pimentpoulet/PFE/Images/plan du site.jpg

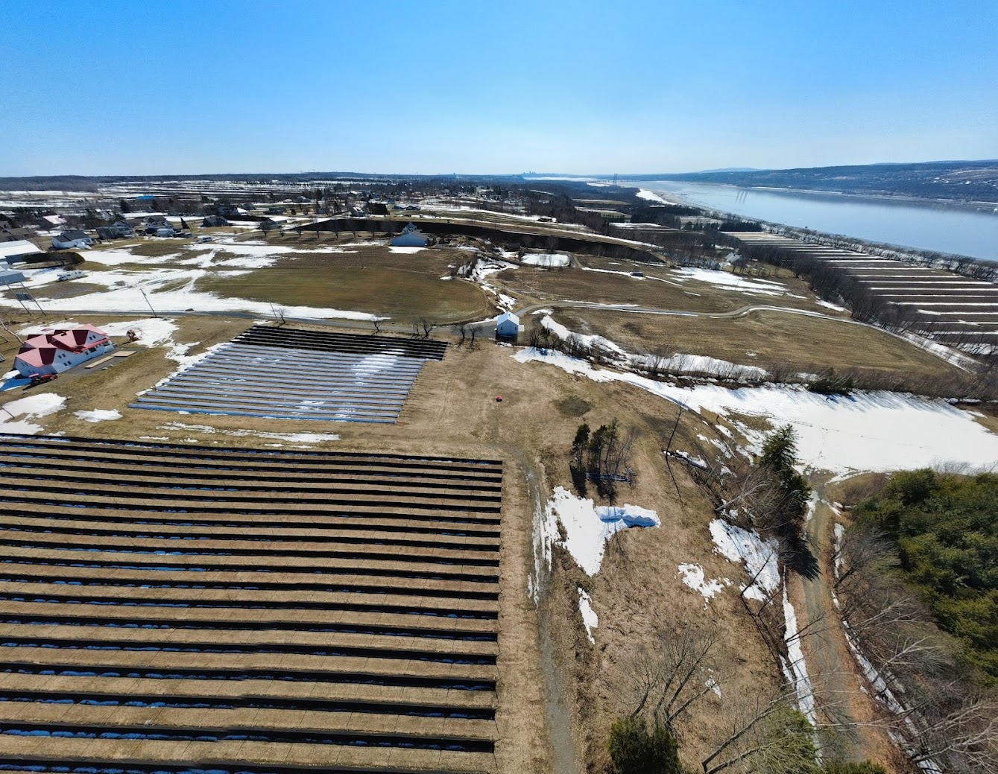
Images/plan du site.jpg
