pimentpoulet/PFE/Images/casing_2.jpg

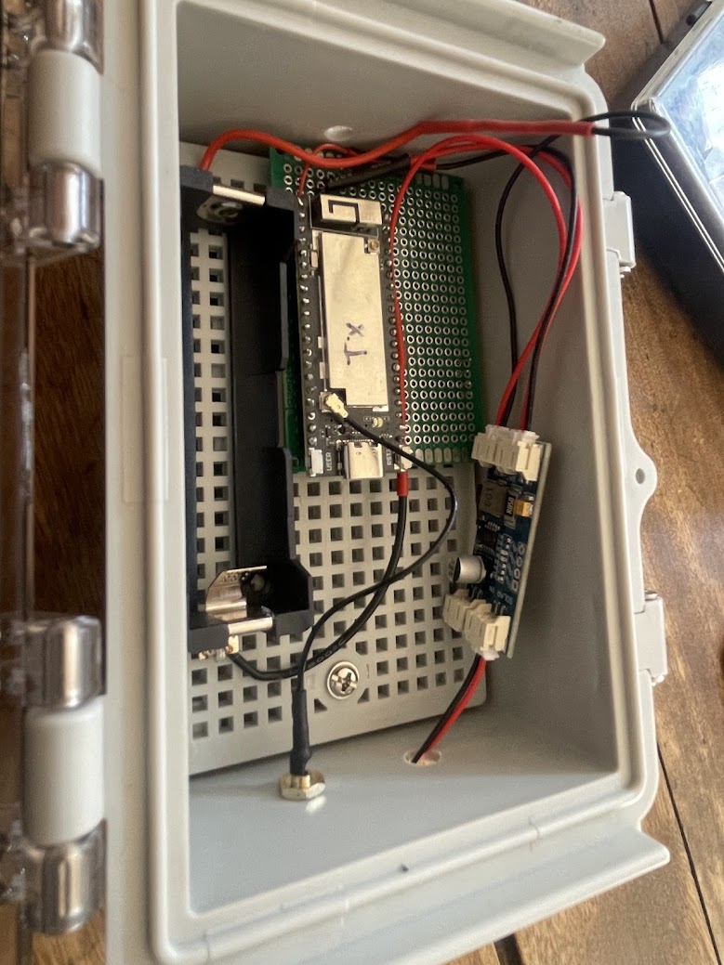
Images/casing_2.jpg
