pimentpoulet/PFE/Ruche connectée.pptx

## Ruche connectée

Clément P.
Michel P. (sup.)

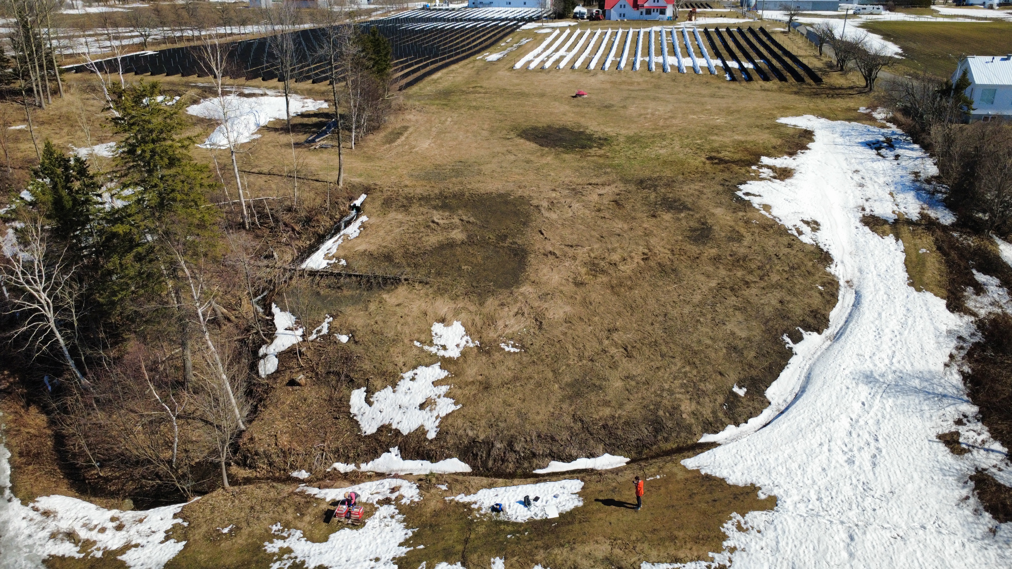
[picture p3: figure]

## Problématique

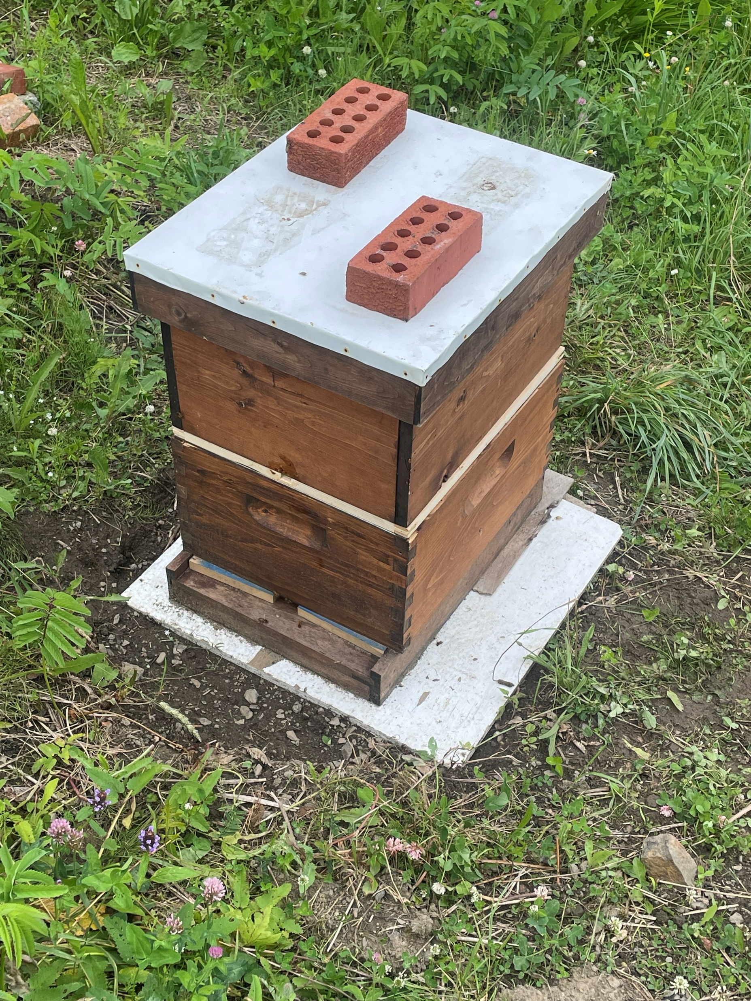
[picture p4: figure]
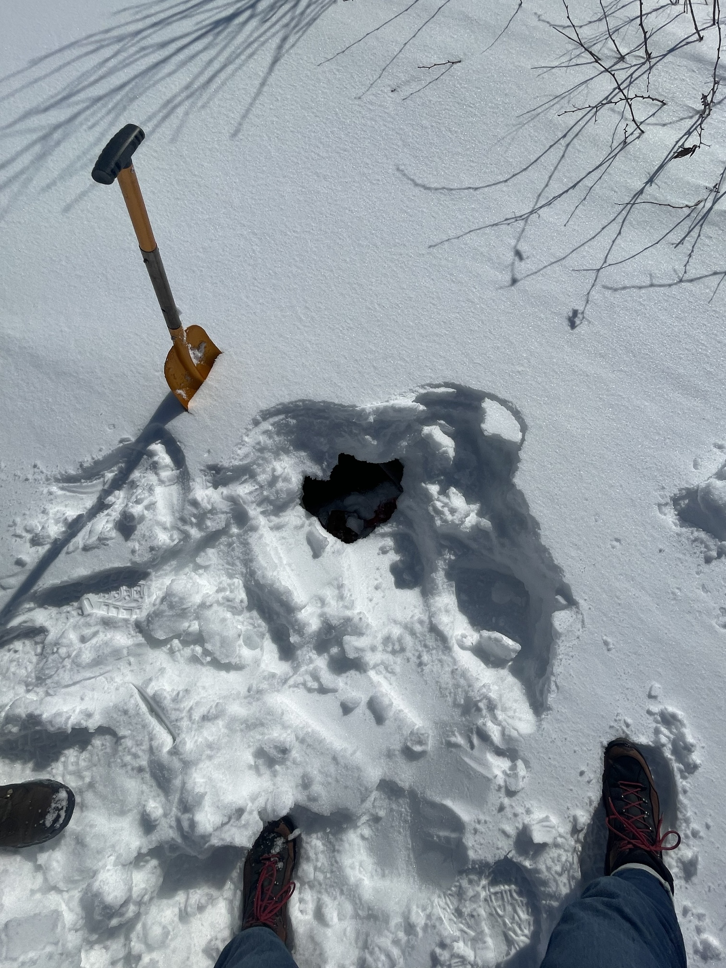
[picture p5: figure]

- État de santé inconnu
- Besoin de déplacement
- Suivi dans le temps compliqué
- Il n’y a pas de réseau à proximité

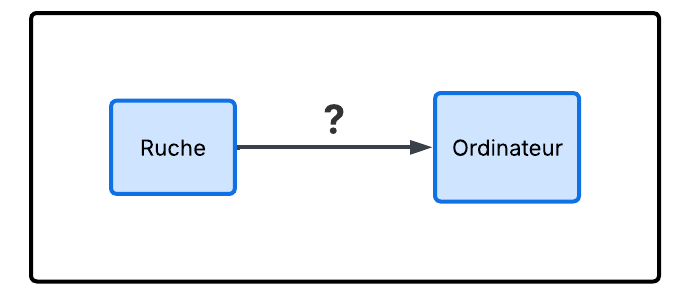
[picture p6: figure]

## Slide 3

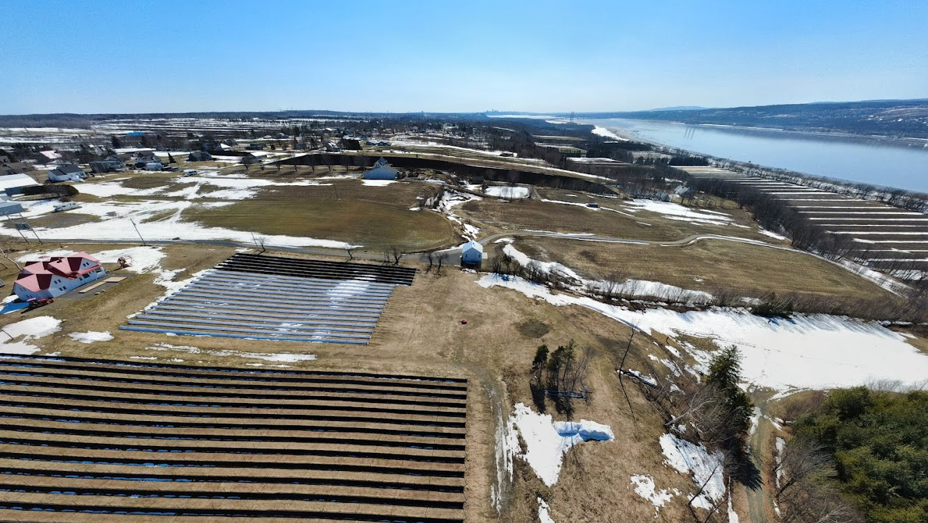
[picture p7: figure]

Plan du site

Centre-ville (maison)

Wi-Fi le plus proche

Distance: ~18km

Distance: ~200m

Ruches

## Solution proposée: Traitement / LoRa

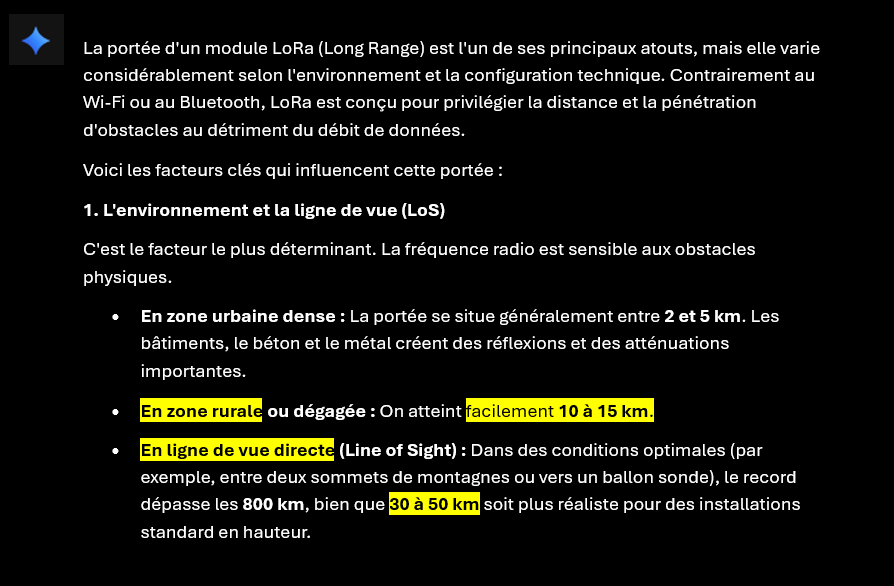
[picture p8: figure]
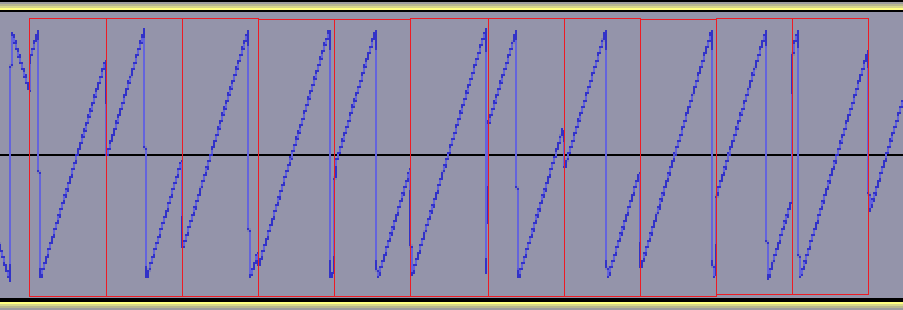
[picture p9: figure]
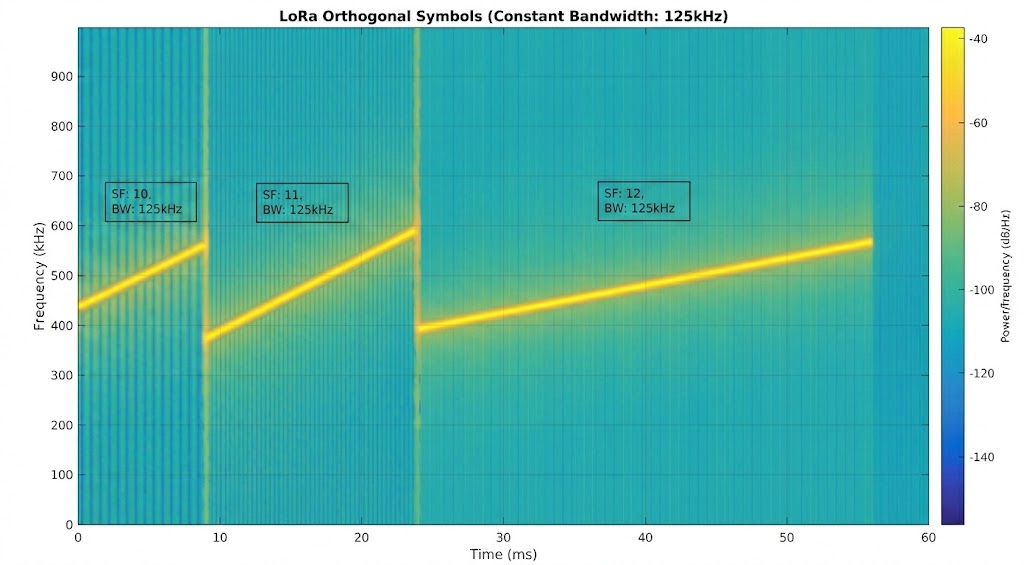
[picture p10: figure]

## Solution proposée: Traitement / LoRa

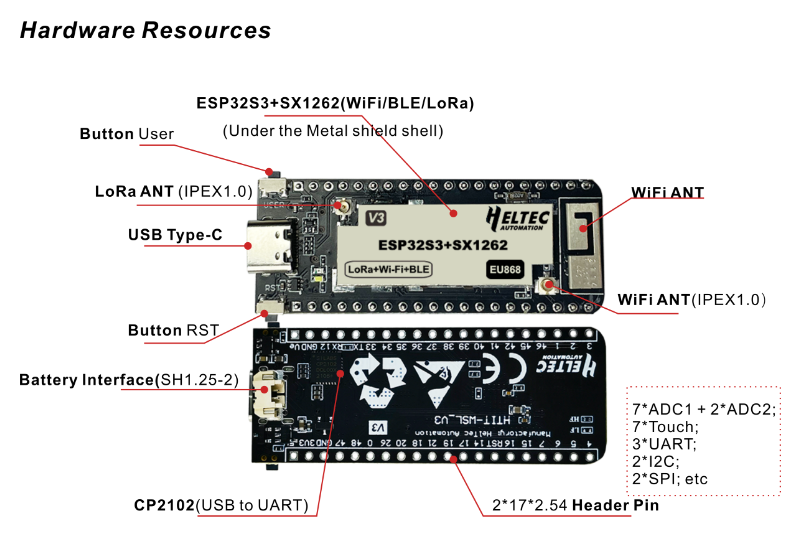
[picture p11: figure]

## Solution proposée : Données

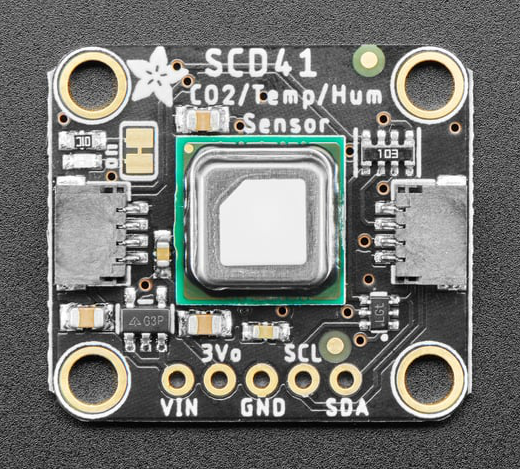
[picture p12: figure]
Top view of Adafruit SCD-41 - NDIR CO2 Temperature and Humidity Sensor.
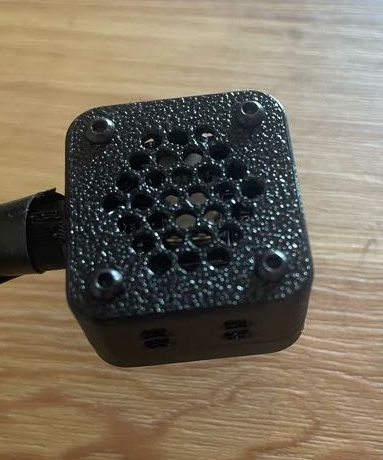
[picture p13: figure]
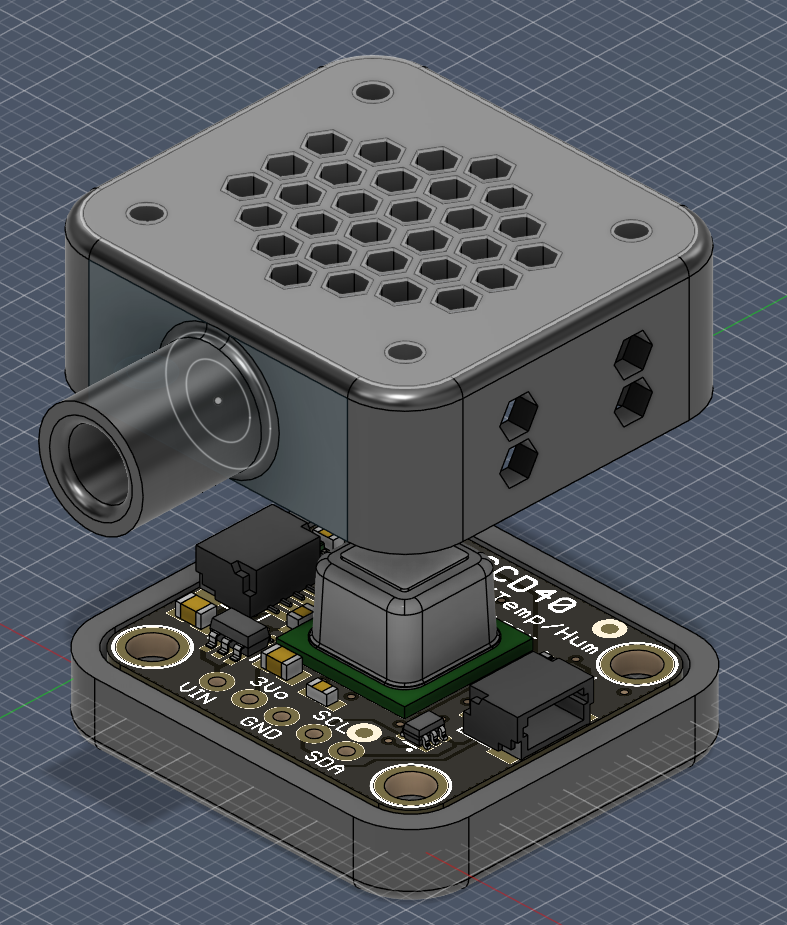
[picture p14: figure]
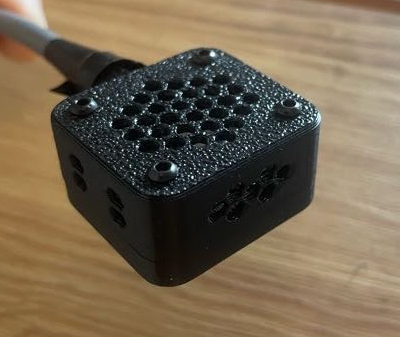
[picture p15: figure]

Notes: CO2: 400-5000ppm \pm 40ppm
Temp: -10 – 60C -> \pm 0.8C
Hum: 0-100% -> \pm 6%

## Solution proposée: Alimentation

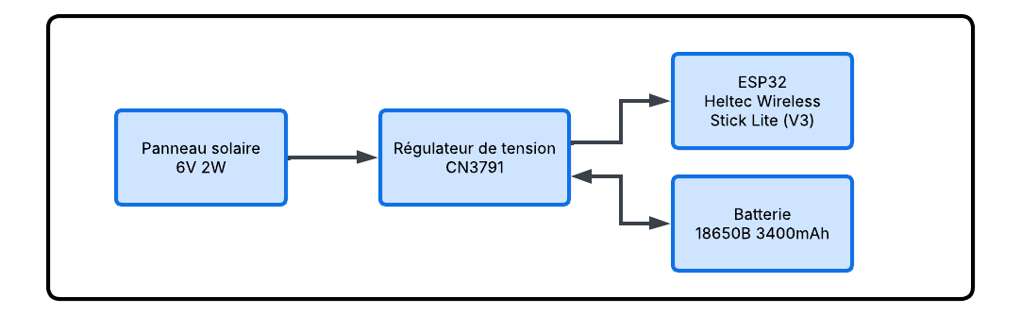
[picture p16: figure]
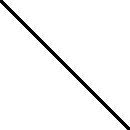
[picture p17: figure]
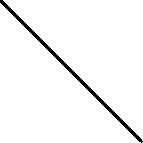
[picture p18: figure]
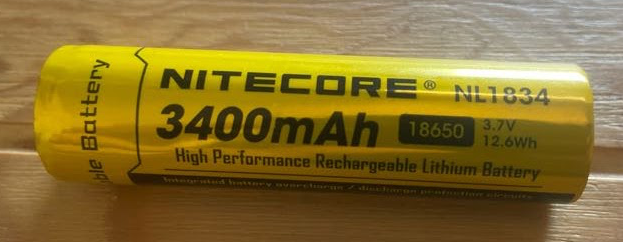
[picture p19: figure]
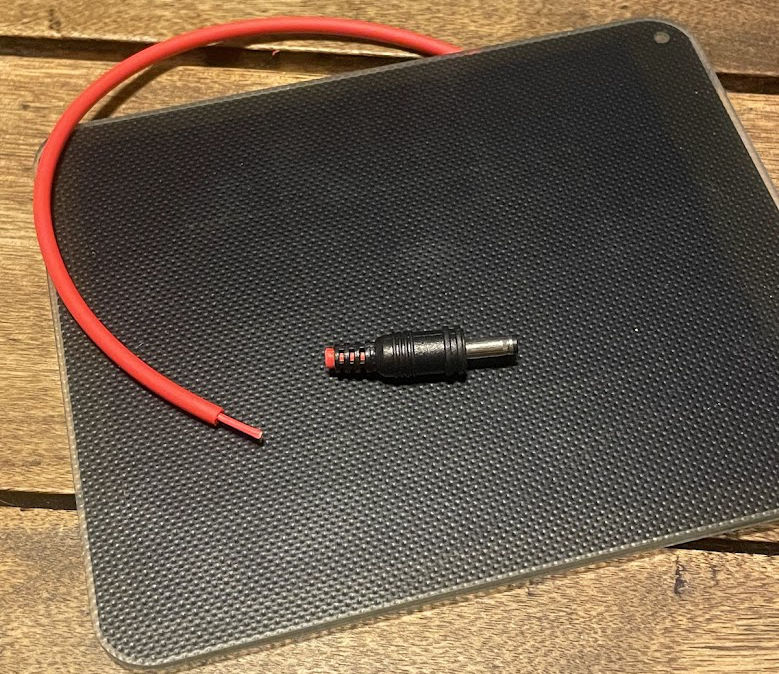
[picture p20: figure]
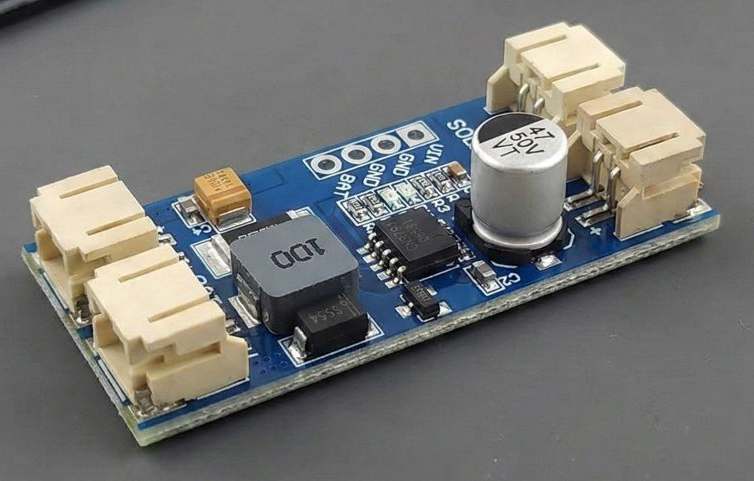
[picture p21: figure]
CN3791 MPPT Solar Li-ion/LiPo Charging Boards: what they are and how to use them safely

Notes: 0.193mAh par cycle
4.64mAh par jour
Batterie 3400 mAh --> ~700 jours

Puissance / jour : 17.2mWh ~ sécurité --> *1.7 = 29.2 mWh --> 2W est largement suffisant

## Solution proposée: Intégration

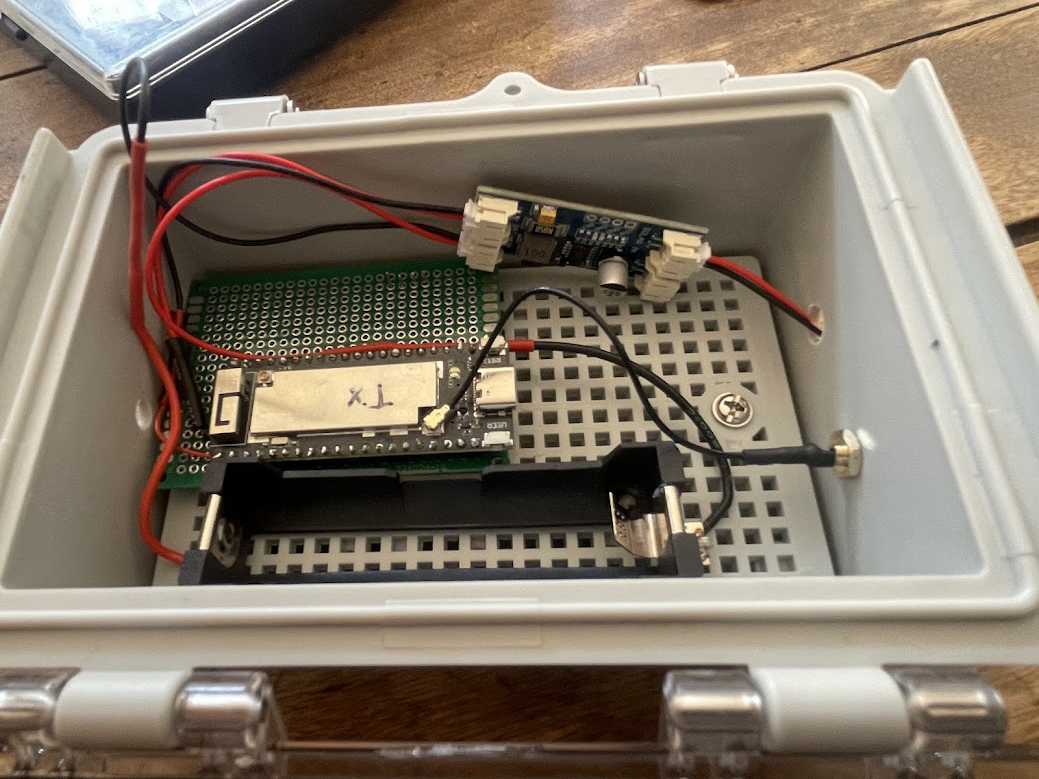
[picture p22: figure]
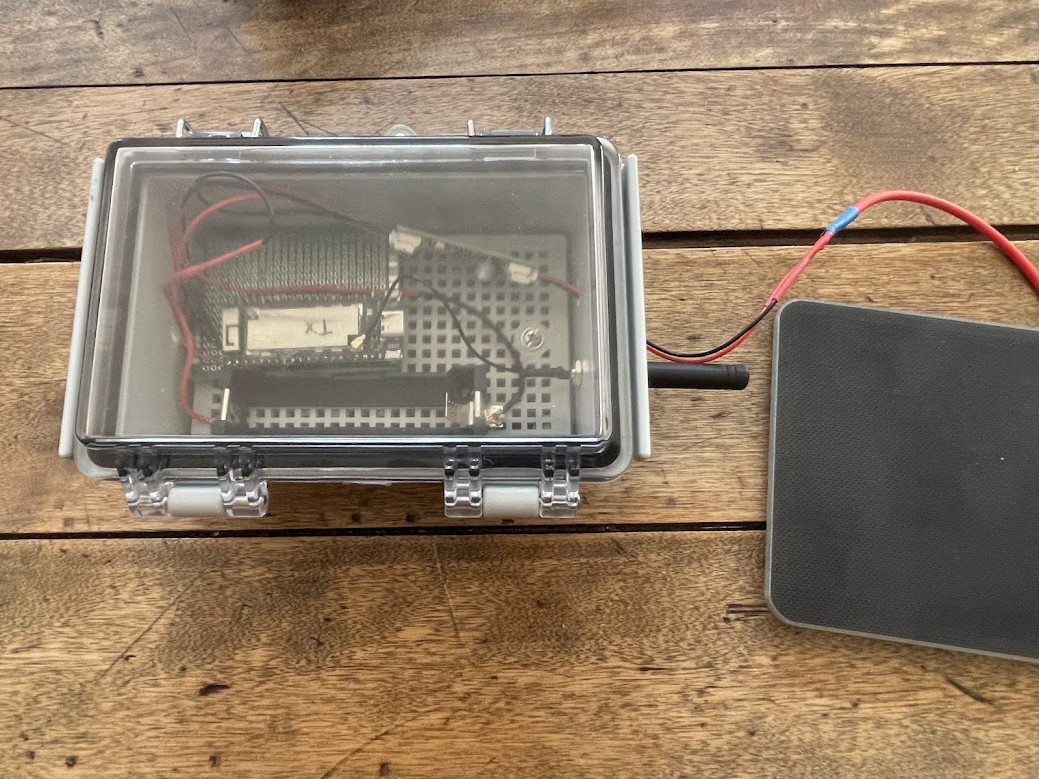
[picture p23: figure]

## Solution proposée : Serveur

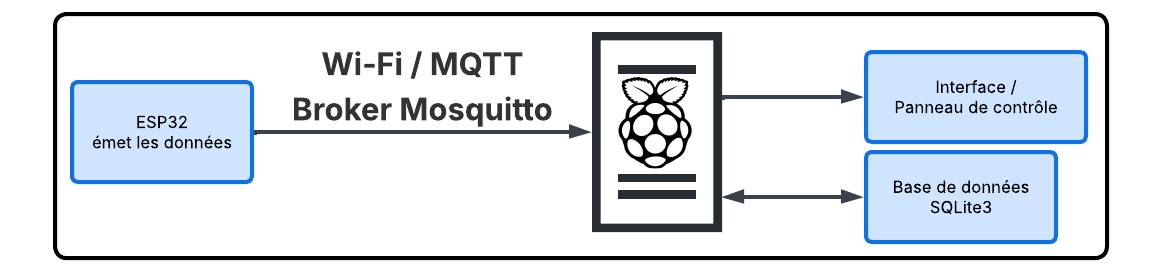
[picture p24: figure]
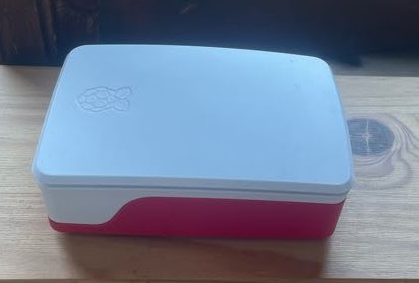
[picture p25: figure]
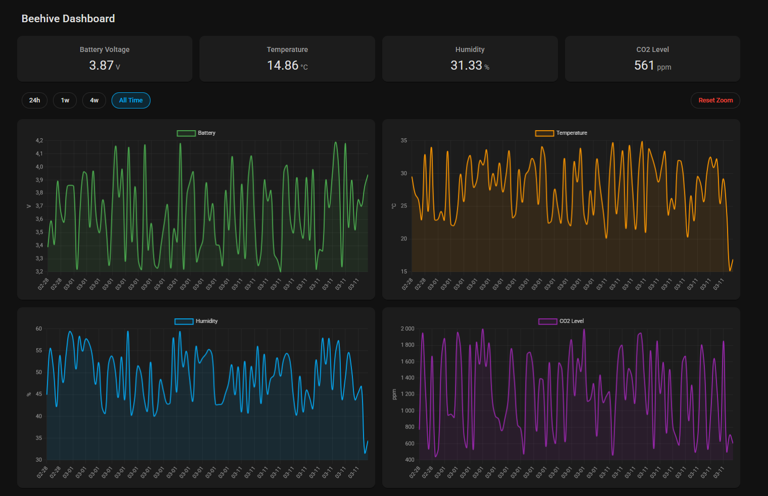
[picture p26: figure]

## Solution proposée : Serveur

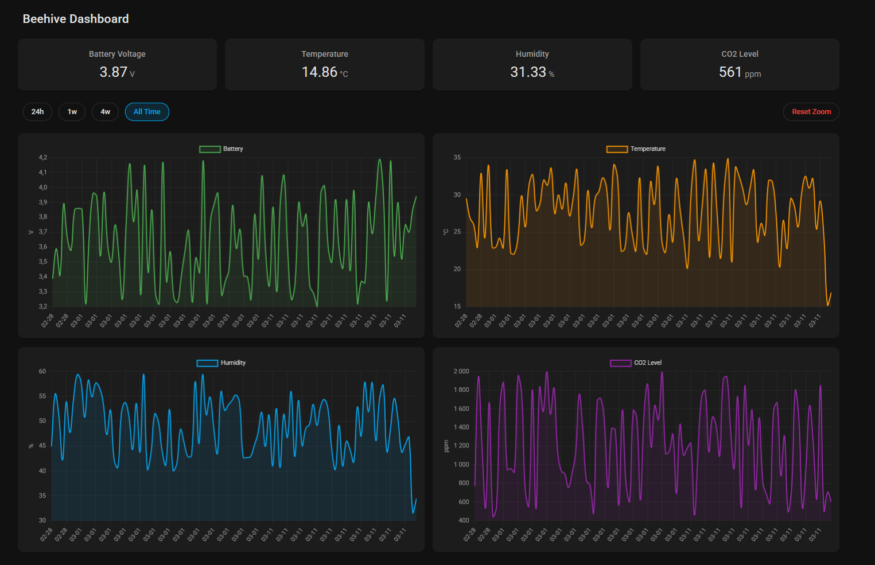
[picture p27: figure]

*Données de tests*

## Solution proposée: Schéma global

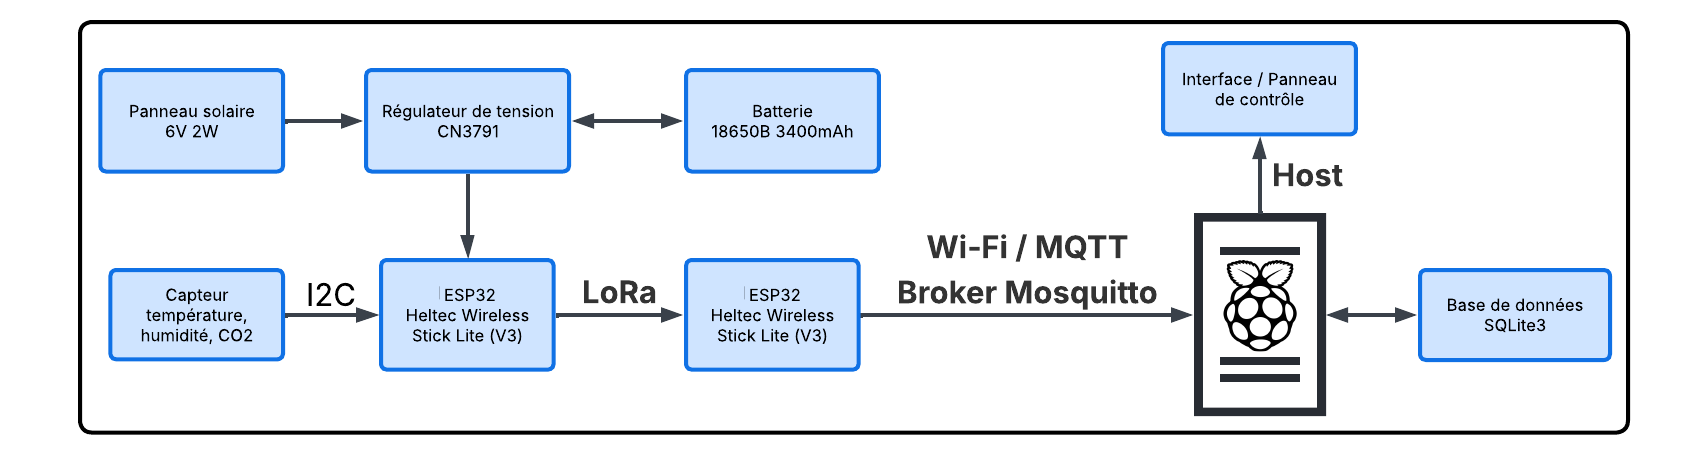
[picture p28: figure]

## Tests de portée – maison

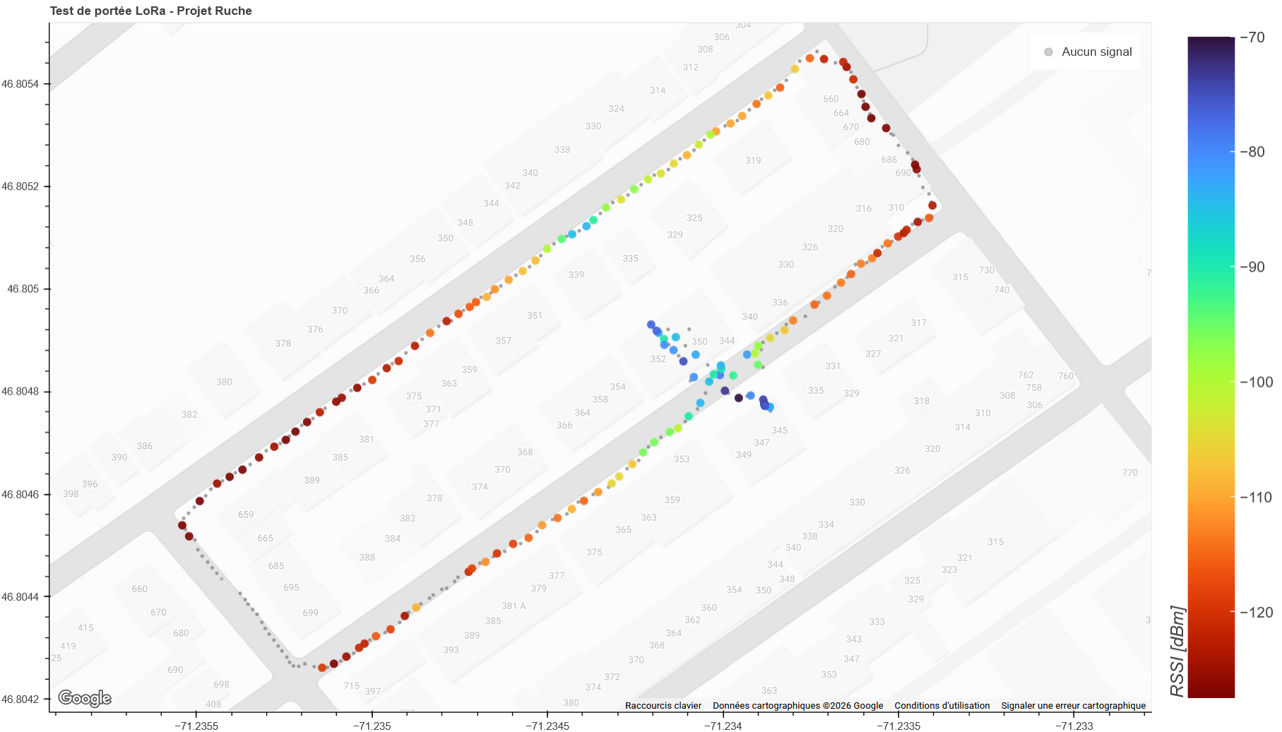
[picture p29: figure]

## Tests de portée – sur site

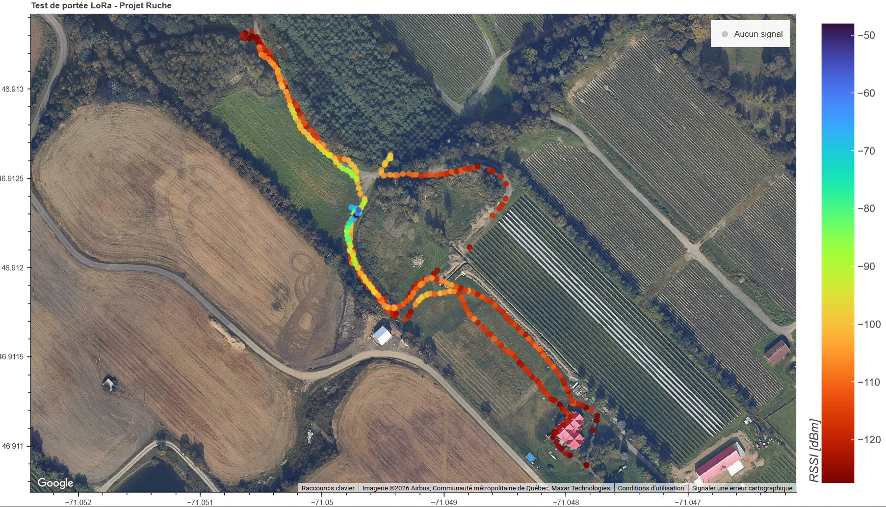
[picture p30: figure]

## Choses à faire

- Tests de portée avec différents paramètres LoRa
- Tests de portée avec réflecteurs à λ/2
- Mise en place définitive du boîtier
- Insertion dans la ruche
- Validation du lien de communication via MQTT Broker
- Changement de l’interface pour le mettre en français⚜️

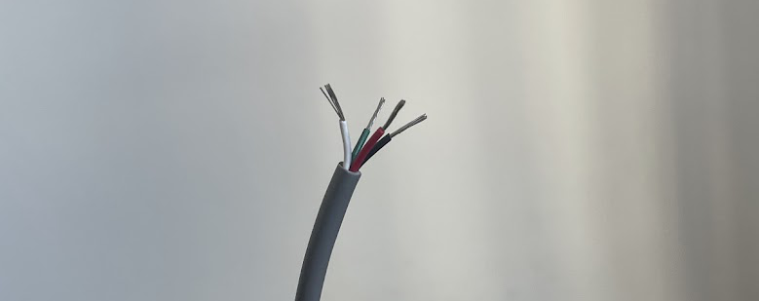
[picture p31: figure]

## Budget

Composante | Quantité | Prix
MCU esp32 | 2 | 22.58$CAD
Capteur SCD41 | 1 | 30.79$CAD
Panneau solaire 6V 2W | 1 | 20.95$CAD
Batterie NRC18650B | 1 | 52.43$CAD
Régulateur de tension CN3791 | 1 | 13.29$CAD
Raspberry Pi 5 | 1 | 151.74$CAD
Carte SD | 1 | 37.95$CAD
Câbles et autres* | - | 41.59$CAD
Total (avec taxes)** | | 393.8$CAD

* inclut le boîtier, le boîtier pour la batterie et tous les connecteurs / adaptateurs
** sans compter les doublons

## Échéancier

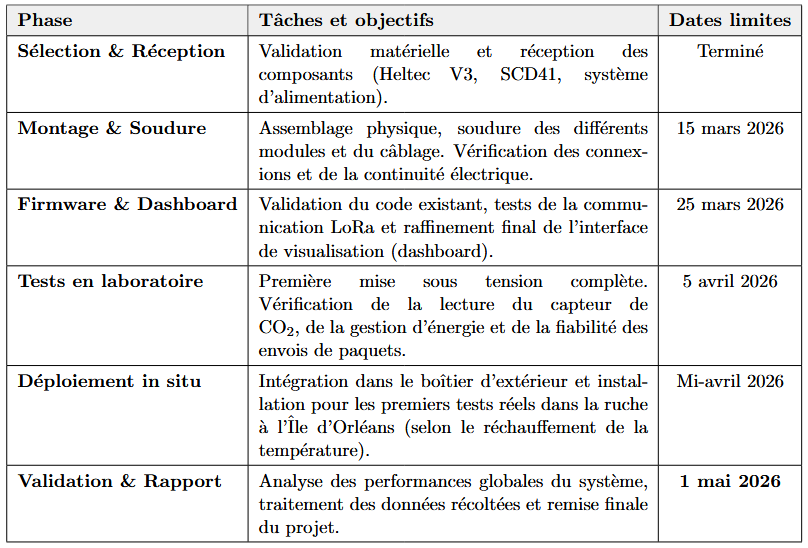
[picture p32: figure]
