pimentpoulet/PFE/PFE_1.pdf

Département de physique, de génie physique et d’optique

Projet de fin d’études
GPH-3001
Hiver 2026

Détail du projet et plan de travail

Clément Poulin (536 994 304)

Date : 30 janvier 2026

## 1 Introduction

L’apiculture moderne fait face à des défis croissants liés aux changements climatiques et à la santé des colonies. L’un des gros défis pour l’apiculture québécoise est la préparation des colonies à l’hivernage, un processus critique où les abeilles doivent avoir suffisamment de réserve de nourriture pour passer l’hiver. Au Québec, le vent et la température hivernale sont de gros facteurs ayant un impact sur l’hivernage des ruches. Un autre facteur préoccupant à chaque année est la quantité de neige qui tombe en hiver. Comme une bonne partie de l’isolation des ruches est due à l’épaisseur de la neige au sol, il faut à chaque automne nourrir les colonies pour qu’elles passent l’hiver et ce peu importe les précipitations de neige. Ce projet, réalisé à l’Île d’Orléans, vise à instrumenter une ruche existante pour permettre un suivi à distance précis. En combinant de l’électronique et, possiblement, les principes de la photonique, il cherche à proposer une solution robuste pour surveiller l’état interne des colonies sans intervention physique disruptive lorsque les apiculteurs ne sont pas directement sur le site.

## 2 Problématique

Un bon apiculteur est un scientifique qui réussi à interpréter les signes que donnent les colonies et à agir en conséquence pour assurer la pérennité de ses abeilles. De façon générale, c’est son habileté à détecter ces signaux qui le distingue d’un débutant et qui facilite son travail au fil des saisons. Pour les apiculteurs qui débutent, il est donc difficile d’interpréter les colonies et poser les bons gestes. Ce projet vise donc à augmenter la visibilité de l’état de santé des colonies par des moyens technologiques. Ces moyens technologiques impliquent plusieurs défis, allant de la gestion des données à la communication et à la visualisation des données.

## 3 Description du projet et objectifs

Le projet consiste à concevoir un système de télémétrie multisensoriel dont les objectifs principaux sont :

- Surveillance environnementale : Mesurer en temps réel la température, l’humidité et le taux de CO2 de la ruche grâce à des capteurs.
- Analyse biologique : Mesurer le niveau de décibels acoustiques pour évaluer l’activité de la colonie.
- Connectivité distante : Etablir un lien de communication fiable entre l’ ´ | Île d’Orléans et
Québec.
- Visualisation : Centraliser les données sur un tableau de bord ergonomique et tenir une base de données ou un fichier permettant de stocker l’information sur une longue durée.
- Autonomie : Assurer une autonomie énergétique du système tout au long de l’année.

Projet de fin d’études
Détail du projet et plan de travail

GPH-3001
Hiver 2026

1

### 3.1 Défis de la surveillance multisensorielle :

Le maintien d’un environnement stable est vital pour la survie des abeilles, particulièrement durant l’hiver. Le défi principal réside dans la sélection et l’intégration de capteurs capables de fonctionner dans un milieu saturé d’humidité et d’encombrement biologique, la propolis :

- Environnemental : La précision des capteurs de température, d’humidité et de CO2 est critique pour détecter précocement une anomalie thermique ou une ventilation inadéquate. Une température trop élevée en été peut montrer un manque de ventilation et est un risque pour les abeilles, qui ont tendance à se laisser mourir lorsque la température monte trop[1]. À l’inverse, une température trop faible en hiver peut indiquer que la colonie est morte. Quant au CO2, les abeilles faisant de la respiration cellulaire, un taux élevé peut indiquer une forte densité de population ou un manque de ventilation.
- Acoustique et vision : L’ajout d’un microphone vise à interpréter le niveau d’activité de la colonie. L’analyse du signal sonore permet de détecter des comportements coloniaux com-plexes. Selon les travaux de Ferrari et al. [2], une augmentation de l’énergie acoustique dans la plage des 100 Hz à 300 Hz est un indicateur précurseur fiable de l’essaimage¹
, permettant
une intervention apicole préventive.

### 3.2 Robustesse face aux interventions apicoles

L’ajout de capteurs ne doit pas empêcher les opérations courantes. Les inspections hebdomadaires au rucher impliquent des manipulations où les hausses des ruches sont déplacées et légèrement brassées. Le prototype doit présenter une architecture robuste et des fixations de capteurs résilientes pour supporter ces déplacements fréquents tout en maintenant l’étalonnage et la connectivité des dispositifs.

### 3.3 Autonomie énergétique et transfert de données

Bien que le site soit accessible, l’alimentation électrique demeure un enjeu majeur. Le système doit minimiser sa consommation pour permettre une autonomie via batterie (éventuellement couplée à une éolienne) ou supporter les contraintes d’un raccordement au réseau de la ferme située à 150 mètres. Cette distance pourrait imposer une transition technologique à un certain point durant le projet : débuter par une liaison câblée pour la validation, puis migrer vers une communication par fibre optique afin de garantir l’intégrité de la connexion face aux distances de transmission. Une fibre optique est aussi beaucoup moins sensible aux variations de température.

1L’essaimage est l’envol d’une partie de la colonie lorsque la population devient trop élevée. C’est une opération qui laisse la colonie sans reine féconde, ce qui réduit les chances de survie naturelle de la colonie.

Projet de fin d’études
Détail du projet et plan de travail

GPH-3001
Hiver 2026

2

## 4 Barèmes du cahier des charges

Le cahier des charges est résumé dans le tableau 1.

### 4.1 Plage d’opération des capteurs

Température : Le système reçoit le pointage maximal s’il maintient une acquisition stable entre -40°C et 55°C, couvrant les extrêmes climatiques de l’Île d’Orléans. L’incertitude sur la limite inférieure ne doit pas excéder 2°C. Un score de 3 pts est accordé si la plage est limitée à [-20°C, 45°C]. 0 pt est attribué si le capteur sature avant d’atteindre les seuils critiques de survie de la grappe hivernale.

Humidité : Ce barème évalue la capacité à mesurer l’humidité relative (%HR) de 0% à 100%. En raison de l’environnement saturé de la ruche, 7 pts sont accordés si le capteur peut récupérer ses spécifications après une condensation totale. Si le capteur dérive ou sature de façon permanente au-dessus de 90% HR, le score est réduit à 2 pts.

Taux de CO2 : Le maximum de points est accordé pour une plage de mesure allant jusqu’à 10 000 ppm. Comme le métabolisme des abeilles produit des concentrations élevées, un capteur limité à 2 000 ppm reçoit 0 pt, car il serait incapable de quantifier les pics d’activité respiratoire de la colonie.

Plage fréquentielle : Le système doit présenter une réponse en fréquence plate entre 20 Hz et 2000 Hz pour capter le spectre complet des vibrations coloniales. Une atténuation majeure (¿ 6 dB) dans la bande de l’essaimage (100-300 Hz) réduit le score à 1 pt.

### 4.2 Précision des capteurs

Température : 7 pts sont accordés pour une incertitude de mesure inférieure ou égale à +/-0.1°C, permettant un suivi fin de l’homéostasie du couvain. Une précision de +/- 1°C récolte 3 pts. Au-delà d’une incertitude de +/- 2°C, la donnée est jugée insuffisante pour une analyse biologique fiable et reçoit 0 pt.

Humidité : Le pointage maximal requiert une précision de +/- 2% HR. Entre 2% et 5%, le score est de 4 pts. Une incertitude supérieure à 10% HR ou une absence de compensation thermique de la mesure d’humidité entraîne un score de 0 pt.

Taux de CO2 : 3 pts sont attribués si l’erreur de mesure est inférieure à 3% de la valeur réelle. Etant donné l’importance de ce gaz pour la régulation de la ventilation, une erreur supérieure à ´ 10% ou une dérive temporelle non calibrée (drift) annule les points de ce critère.

Plage fréquentielle : Ce critère évalue la résolution spectrale de la transformée de Fourier (FFT).

Projet de fin d’études
Détail du projet et plan de travail

GPH-3001
Hiver 2026

3

Le maximum est accordé pour une résolution inférieure ou égale à 5 Hz par bin, essentielle pour isoler les signatures acoustiques. Une résolution trop grossière (¿ 20 Hz) ne permet pas de distinguer les signaux d’intérêt et reçoit 0 pt.

### 4.3 Fiabilité de la communication et tableau de bord

Fiabilité de la connexion : Evalue la stabilité du lien de communication de 150m vers Québec. ´ 25 pts sont accordés pour une disponibilité du signal supérieure à 99% (uptime). Le score est réduit proportionnellement au taux de perte de paquets ou de déconnexions lors d’intempéries (ex: 10 pts pour 80% de stabilité).

Lisibilité et convivialité : Barème qualitatif basé sur l’ergonomie du tableau de bord. 10 pts si un utilisateur peut identifier une anomalie thermique, acoustique ou autres en moins de 5 secondes. 0 pt si l’interface est surchargée, instable ou nécessite une conversion manuelle des données brutes par l’apiculteur.

Actualisation des données : 5 pts si le délai entre la capture et l’affichage à Québec est inférieur à 1 minute. Le score est de 0 pt si l’actualisation excède 10 minutes, rendant le monitoring inefficace pour une intervention d’urgence.

### 4.4 Autonomie et robutesse

Autonomie énergétique : Le système reçoit 15 pts s’il peut fonctionner de manière totalement autonome pendant 48h sans apport externe (solaire ou éolien). Le score diminue de 5 pts par tranche de 12h d’autonomie manquante par rapport à cette cible.

Robustesse globale :

Manipulations : Evalué par un test de résistance aux vibrations. Le prototype doit rester fonc- ´ tionnel et conserver l’intégrité de ses branchements après que les hausses de la ruche aient été manipulées ou déplacées brusquement.

Conditions environnementales : 2.5 pts si aucune défaillance n’est observée après une exposition à l’humidité interne et aux agents corrosifs (propolis/cire). 0 pt si des débris bloquent les ouvertures acoustiques ou les membranes des capteurs.

Projet de fin d’études
Détail du projet et plan de travail

GPH-3001
Hiver 2026

4

## 5 Cahier des charges

Paramètres | Pond. | Barême | Min | Max
Plage d’opération des capteurs ◦C] Température [ [%HR] Humidité Taux de CO2 [ppm] Plage frqéuentielle [Hz] | 20 7 7 3 3 | 4.1 4.1 4.1 4.1 | -40 0 0 20 | 55 100 10000 2000
Précision des capteurs ◦C] Température [ Humidité [%HR] Taux de CO2 [ppm] [Hz] Plage fréquentielle | 20 7 7 3 3 | 4.2 4.2 4.2 4.2 | ±1 5% 3% - | ±0.1 2% --
Fiabilité de la connexion longue distance | 25 | 4.3 | - | -
Tableau de bord Lisibilité des données et facilité d’utilisation Actualisation des données régulièrement | 15 10 5 | 4.3 4.3 | -- | --
Autonomie énergétique | 15 | 4.4 | - | -
Robustesse globale du système face aux manipulations des opérateurs face aux conditions environnementales | 5 2.5 2.5 | 4.4 4.4 | -- | --

Tableau 1

Projet de fin d’études
Détail du projet et plan de travail

GPH-3001
Hiver 2026

5

## 6 Echéancier ´

Phase | Tâches et objectifs | Dates limites
Design & Sélection | Recensement final des capteurs et composants. Etude de faisabilité ESP32. Choix entre ´ intégration directe ou modules. | 8 fév. 2026
Conception PCB | Saisie du schéma électronique et routage du circuit (Layout). Commande des PCBs auprès du fabri-cant. | 1 mars 2026
Firmware (Base) | Programmation de la lecture des capteurs sur plaque d’essai. Test des protocoles (Wi-Fi/Fibre). | 15 mars 2026
Montage & Soudure | Réception des PCBs, soudure des composants et tests de continuité électrique. | 25 mars 2026
Dashboard & Cloud | Développement de l’interface de visualisation (Grafana/Web) et base de données distante. | 10 avril 2026
Intégration Physique | Fabrication du boîtier robuste (IP65) et installa-tion finale au vignoble (Île d’Orléans). | 20 avril 2026
Validation & Rapport | Analyse des données, calcul des incertitudes et remise finale du projet GPH-3001. | 1 mai 2026

Tableau 2: Echéancier de réalisation. ´

## References

[1] Radio-Canada, | “Le | stress | thermique | cause | l’éjaculation | mortelle
des | faux-bourdons.” | https://ici.radio-canada.ca/nouvelle/1866437/
abeilles-ruches-changements-climatiques-cb-ubc-recherche-ejaculation, (https://ici.radio-canada.ca/nouvelle/1866437/abeilles-ruches-changements-climatiques-cb-ubc-recherche-ejaculation) | 2022.
Consulté le 30 janvier 2026.
[2] S. Ferrari, M. Silva, M. Guarino, and D. Berckmans, “Monitoring of swarming sounds in bee colonies for early detection,” Computers and Electronics in Agriculture, vol. 64, no. 1, pp. 72–77, 2008.

Projet de fin d’études
Détail du projet et plan de travail

GPH-3001
Hiver 2026

6
