pimentpoulet/PFE/Images/Alimentation.jpg

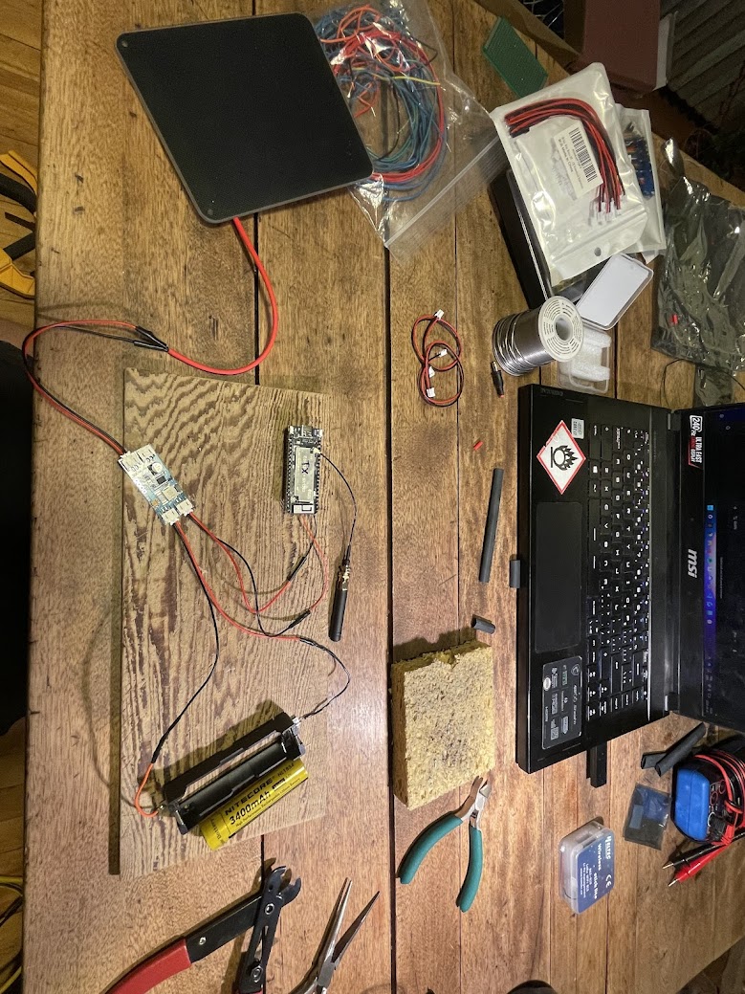
Images/Alimentation.jpg
