pimentpoulet/PFE/Images/casing_1.jpg

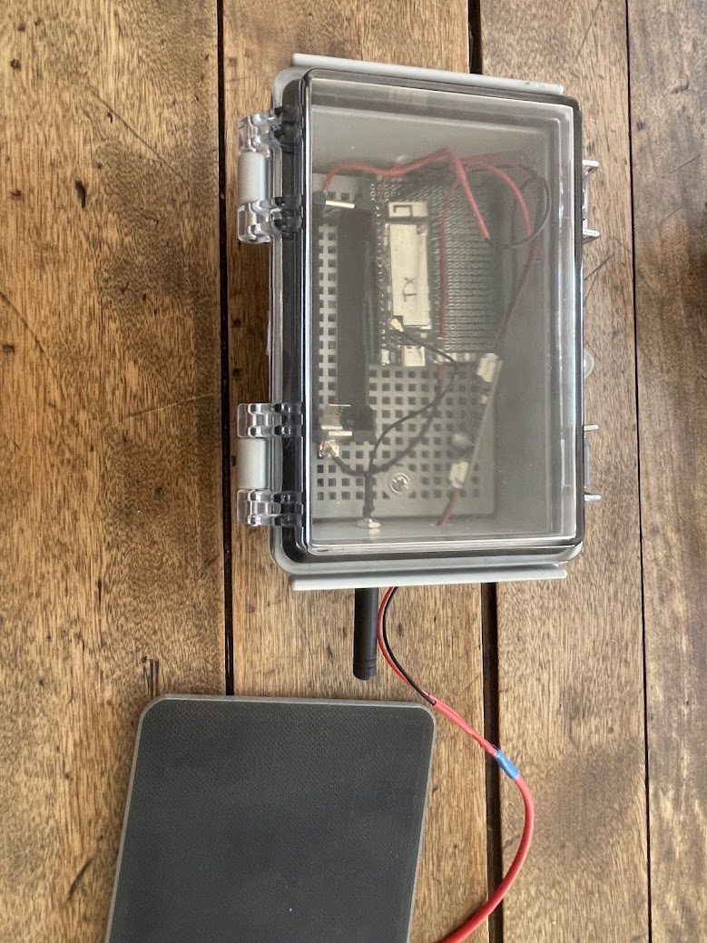
Images/casing_1.jpg
