pimentpoulet/PFE/Images/Dashboard.png

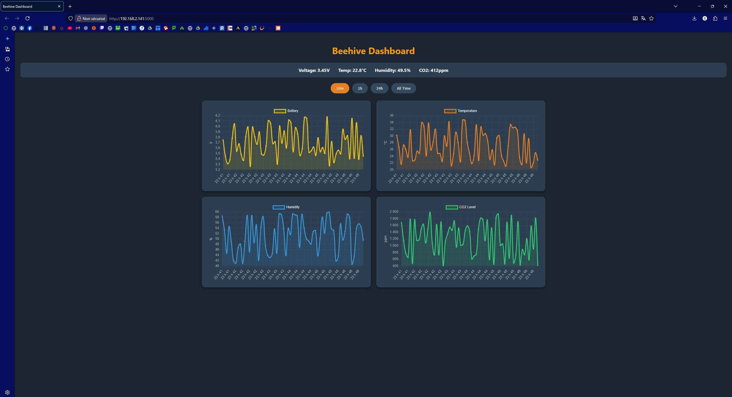
Images/Dashboard.png
