pimentpoulet/PFE/Images/Dashboard_2.png

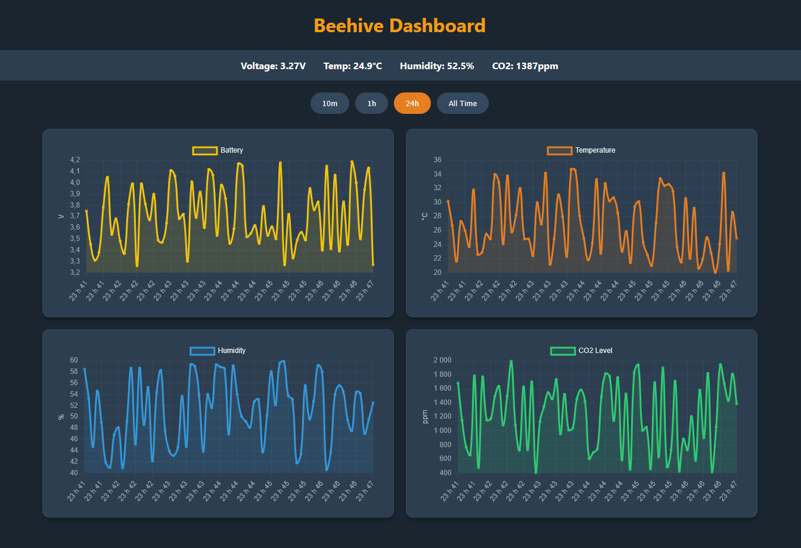
Images/Dashboard_2.png
