pimentpoulet/PFE/Images/Fils_capteurs.jpg

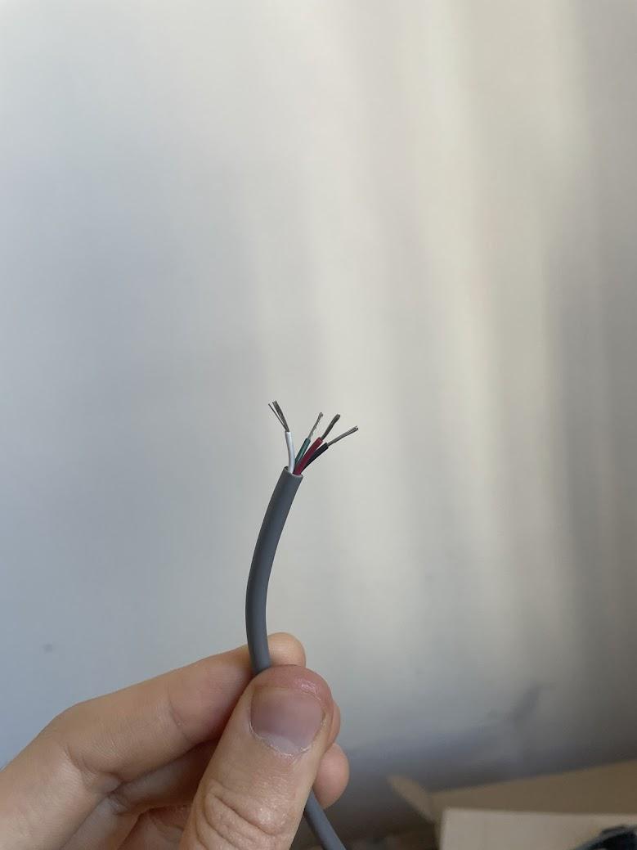
Images/Fils_capteurs.jpg
