pimentpoulet/PFE/Images/RPI5.jpg

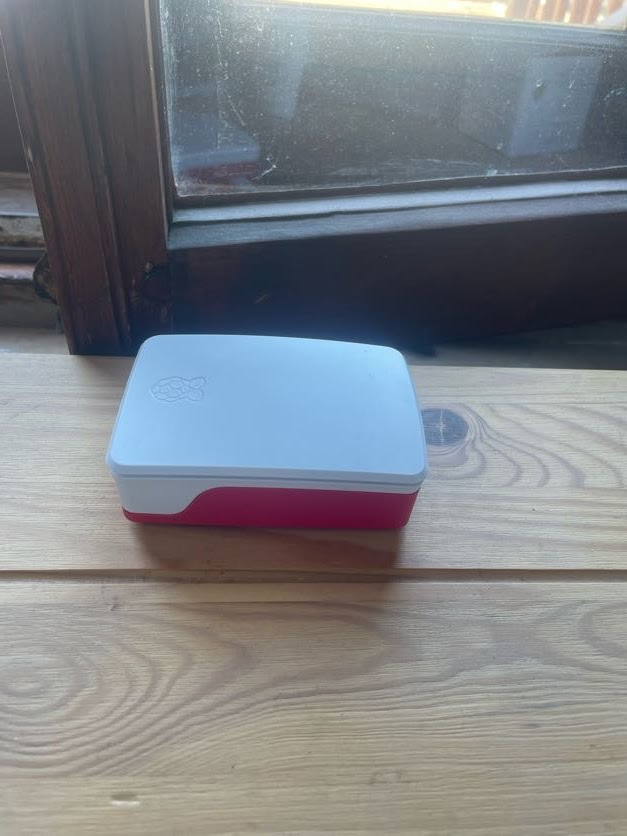
Images/RPI5.jpg
