pimentpoulet/PFE/Images/ruche_neige_zoom.jpg

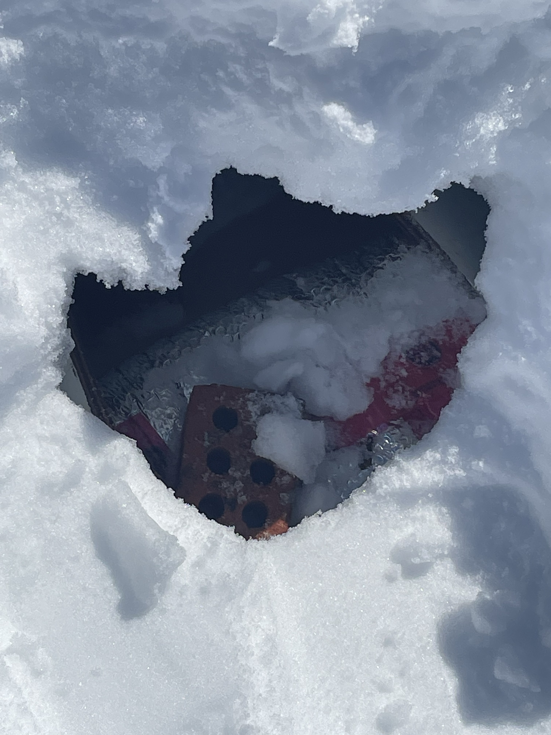
Images/ruche_neige_zoom.jpg
