pimentpoulet/PFE/Images/SCD41_1.jpg

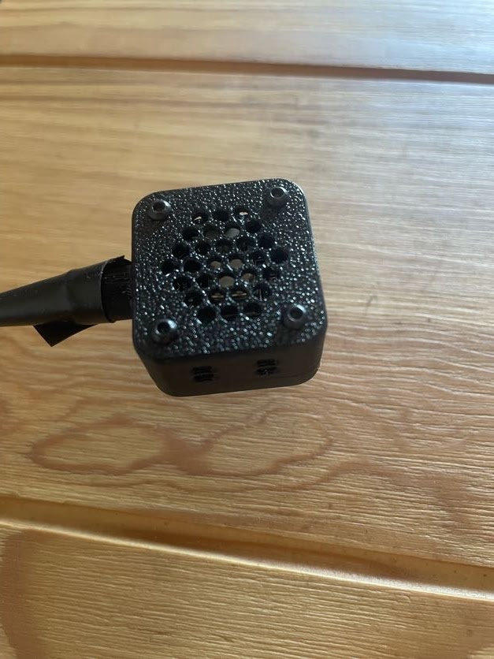
Images/SCD41_1.jpg
