pimentpoulet/PFE/Images/SCD41_2.jpg

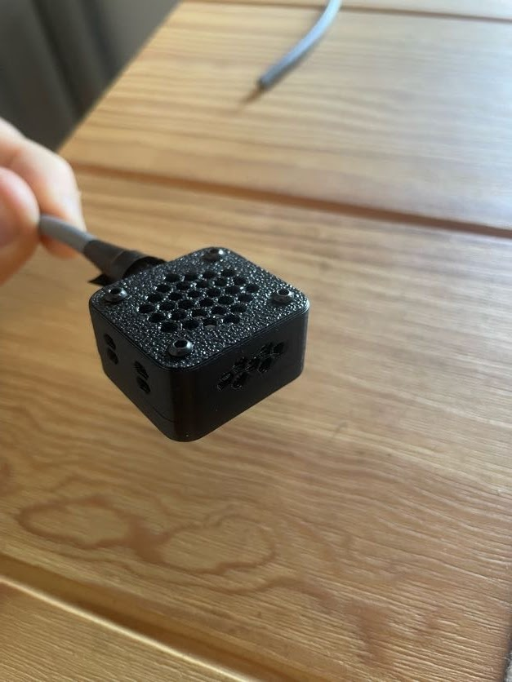
Images/SCD41_2.jpg
