pimentpoulet/PFE/Images/Schema.png

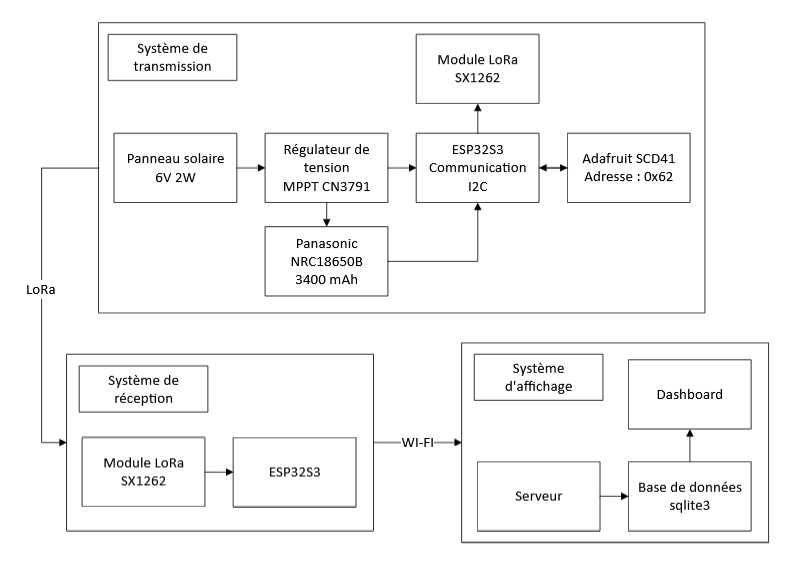
Images/Schema.png
