pimentpoulet/PFE/Images/Solar_panel.jpg

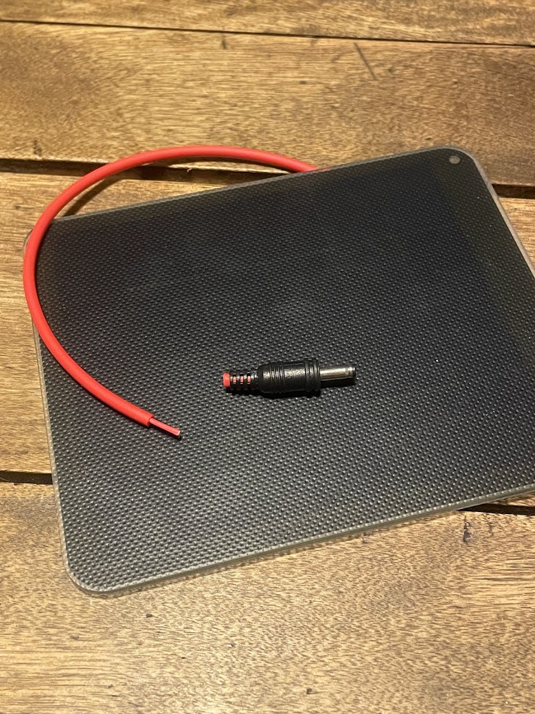
Images/Solar_panel.jpg
