pimentpoulet/PFE/SNR_RSSI_data.png

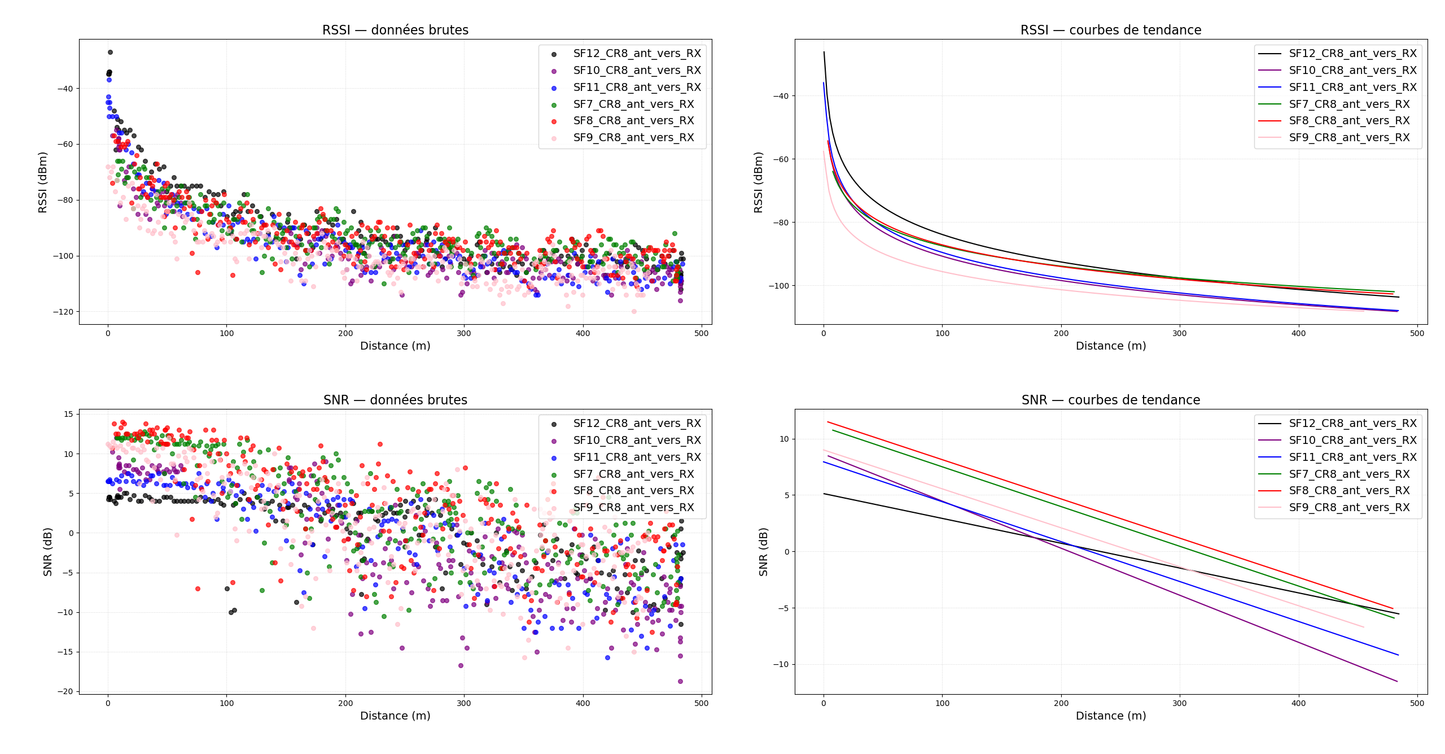
SNR_RSSI_data.png
