pimentpoulet/PFE/Adafruit SCD41/Adafruit_SCD-41_Bottom.step

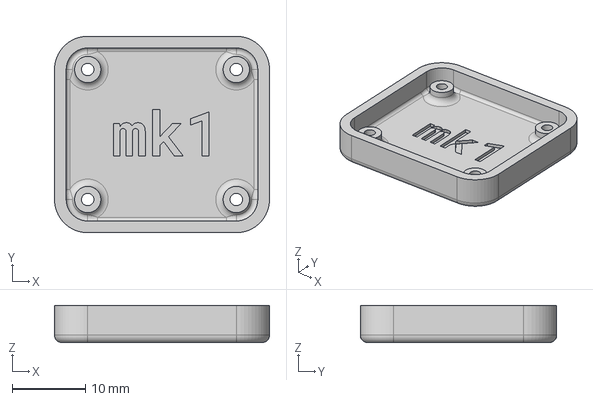
[picture p45: CAD file, 2026-04-06]
Adafruit SCD41/Adafruit_SCD-41_Bottom.step
29.4 x 26.9 x 5.07 mm
