pimentpoulet/PFE/Adafruit SCD41/Adafruit_SCD-41_Top.step

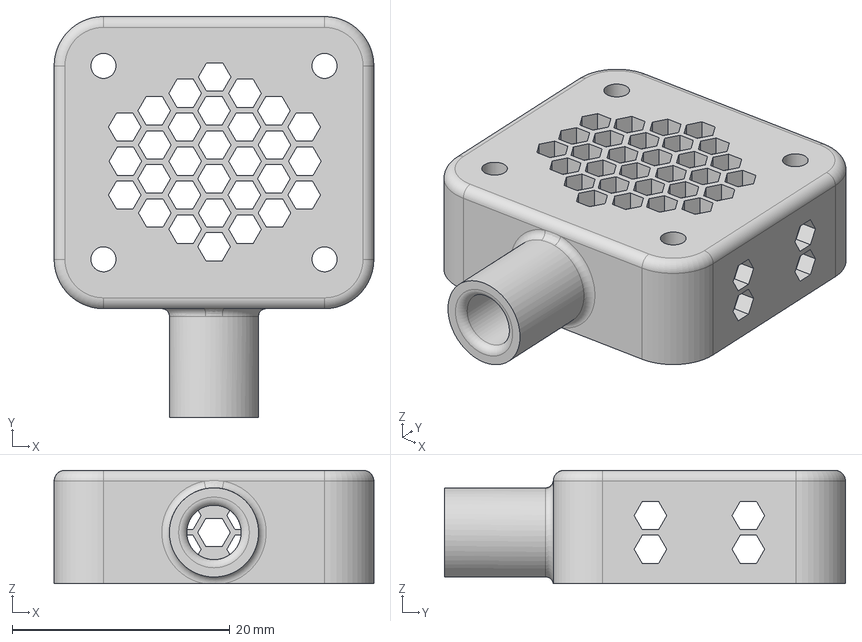
[picture p46: CAD file, 2026-04-06]
Adafruit SCD41/Adafruit_SCD-41_Top.step
29.4 x 36.9 x 10.4 mm
