pimentpoulet/PFE/(list of files, cad)

Other CAD files:
Adafruit SCD41/5187 SCD-40 C02 Sensor.f3d
Adafruit SCD41/Adafruit_SCD-41_Enclosure.f3d
