pimentpoulet/PFE/distance_data/2026_04_17_distance_test_ile.csv

lat | lon | rssi | snr
46.91262916666667 | -71.04944 | -103.0 | 0.75
46.91262916666667 | -71.04944
46.9126285 | -71.049439
46.9126285 | -71.049439
46.912627 | -71.04943983333334
46.912627 | -71.04943983333334 | -100.0 | 2.75
46.91261183333334 | -71.04943866666666
46.91261183333334 | -71.04943866666666 | -100.0 | 2.5
46.91260366666667 | -71.04942883333334
46.91260366666667 | -71.04942883333334
46.91261083333333 | -71.04945083333334
46.91261083333333 | -71.04945083333334 | -96.0 | 3.75
46.9125955 | -71.04946
46.9125955 | -71.04946
46.912586833333336 | -71.04948066666667
46.912586833333336 | -71.04948066666667 | -99.0 | 2.0
46.912586 | -71.0494785
46.912586 | -71.0494785
46.912576 | -71.04948666666667
46.912576 | -71.04948666666667 | -100.0 | 1.25
46.91256683333334 | -71.04949583333334
46.91256683333334 | -71.04949583333334
46.9125465 | -71.04951383333334
46.9125465 | -71.04951383333334 | -104.0 | -1.5
46.912532666666664 | -71.0495145
46.912532666666664 | -71.0495145
46.912529666666664 | -71.04951383333334
46.912529666666664 | -71.04951383333334 | -101.0 | 1.25
46.91251183333333 | -71.049507
46.91251183333333 | -71.049507
46.91251483333333 | -71.0494935
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
