pimentpoulet/PFE/distance_data/distance_tests.csv

lat | lon
46.8048295 | -71.2337885
46.80482816666667 | -71.23378716666667
46.80482816666667 | -71.23378716666667
46.804827 | -71.2337875
46.804827 | -71.2337875
46.8048265 | -71.23378766666667
46.8048265 | -71.23378766666667
46.804825 | -71.23379016666667
46.804825 | -71.23379016666667
46.80482533333333 | -71.23377816666667
46.80482533333333 | -71.23377816666667
46.80483133333333 | -71.23376016666667
46.80483133333333 | -71.23376016666667
46.80483916666667 | -71.23374383333334
46.80483916666667 | -71.23374383333334
46.80484966666667 | -71.233731
46.80484966666667 | -71.233731
46.80486166666667 | -71.23372266666667
46.80486166666667 | -71.23372266666667
46.804884 | -71.233787
46.804884 | -71.233787
46.8048995 | -71.23377266666667
46.8048995 | -71.23377266666667
46.80491116666666 | -71.2337575
46.80491116666666 | -71.2337575
46.804921666666665 | -71.23374516666667
46.804921666666665 | -71.23374516666667
46.804929666666666 | -71.2337265
46.804929666666666 | -71.2337265
46.8049405 | -71.2337045
46.8049405 | -71.2337045
46.804938 | -71.233753
46.804938 | -71.233753
46.804945333333336 | -71.23373566666666
46.804945333333336 | -71.23373566666666
46.804954 | -71.23372016666667
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
