pimentpoulet/PFE/RPI5/backup codes.pdf

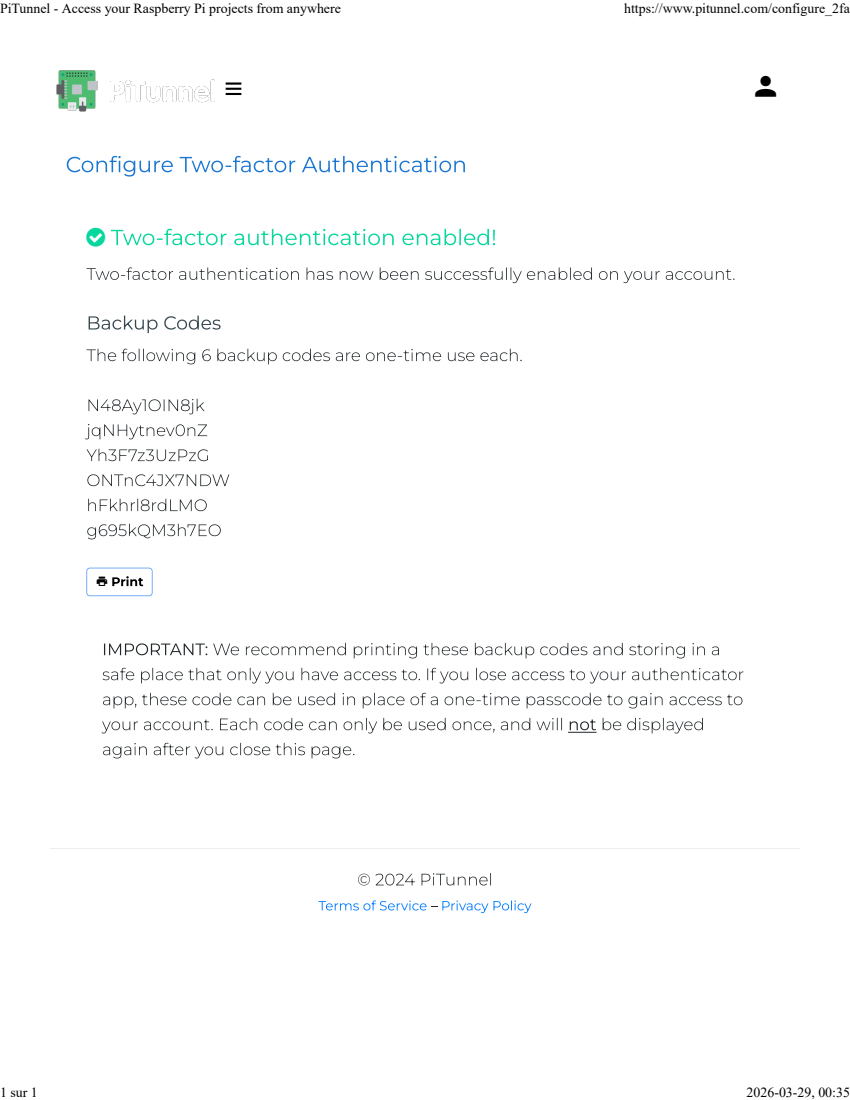
[picture p47: page 1]
PiTunnel - Access your Raspberry Pi projects from anywhere; https://www.pitunnel.com/configure_2fa; 1 sur 1
