pimentpoulet/PFE/(commit log)

2026-03-18 Communication update
    Sensor enabled
    LoRa enabled
    WiFi enabled
    Server running
    Dashboard active
2026-03-23 scd41 update
    [5187 SCD-40 C02 Sensor.SLDASM, Adafruit SCD-41.PcbDoc, Adafruit SCD-41.PrjPcb, Adafruit SCD-41.SchDoc, Adafruit SCD-41.brd, Adafruit SCD-41.sch, Pièce1.SLDPRT]
2026-04-02 geo_11
    premier test dehors
    [distance_data.csv]
2026-04-06 geo_16
    code de mapping terminé
    .step envoyé à jé pour l'impression 3D
    [Adafruit_SCD-41_Bottom.step, Adafruit_SCD-41_Top.step]
2026-04-10 Alimentation update
    [Analyse consommation énergie ruche monitoring.xlsx]
2026-04-18 map update
    [2026_04_17_distance_test_ile.csv]
2026-04-29 test plaines
    [2026_04_17_distance_test_ile.csv, 2026_04_29_distance_plaines_SF10_CR8_ant_vers_RX.csv, 2026_04_29_distance_plaines_SF11_CR8_ant_vers_RX.csv, 2026_04_29_distance_plaines_SF12_CR8_ant_VARIEE.csv, 2026_04_29_distance_plaines_SF12_CR8_ant_vers_ciel_reflecteur.csv, 2026_04_29_distance_plaines_SF12_CR8_ant_vers_ciel_reflecteur_2.csv, 2026_04_29_distance_plaines_SF7_CR8_ant_vers_RX.csv, 2026_04_29_dist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]
